loggerhead-instruments/opentag/(commit log)

2016-08-06 Temp and Pressure
2016-08-10 fix pressure timestamp
2016-08-10 Sample data processing of opentag files by dives
2016-08-10 OpenTag to NED orientation. Pitch, roll, yaw calculation
2017-01-10 OpenTag code to sample Z accelerometer at 1400 Hz and save as wav
2017-01-10 count each half buffer written so files correct length, even if overflow
    [OT_wav.ino]
2017-10-05 update Wire commands to Arduino v1.8. Update to latest SDFAT
2017-10-05 fix logic for VHF on always after burn
    [OpenTagGAMPT31.ino, cmd.ino]
2017-10-05 change bitwise not to !
    In new arduino, wasn't toggling, so depth/temp sensor not updating properly
